festlv/uSMU/Enclosure/uSMU-top.STEP

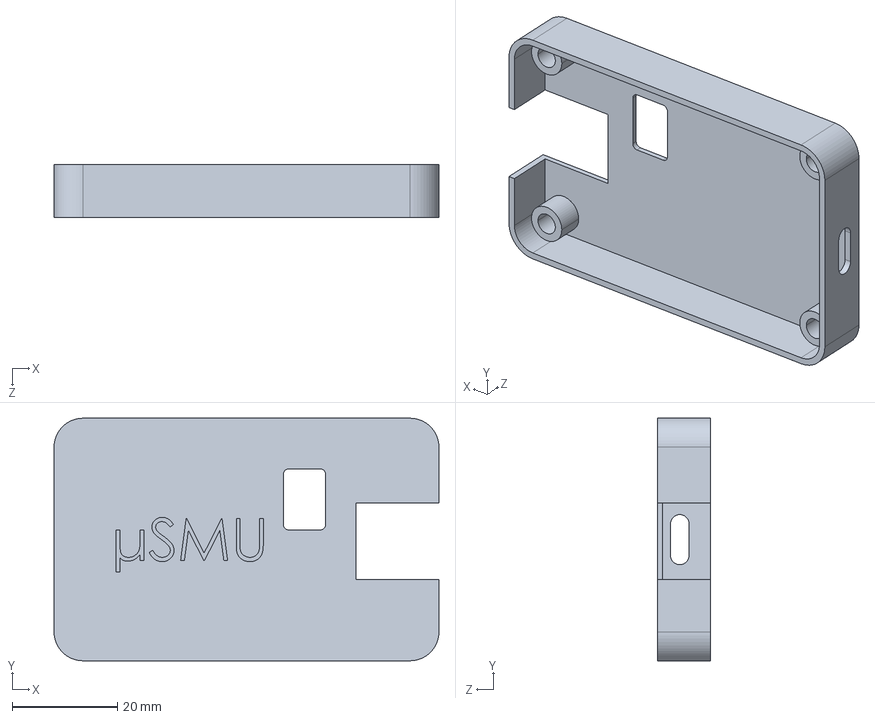
[picture p2: CAD file, 2024-10-05]
Enclosure/uSMU-top.STEP
73.0 x 46.0 x 10.1 mm
