festlv/uSMU/Enclosure/uSMU-bot.STEP

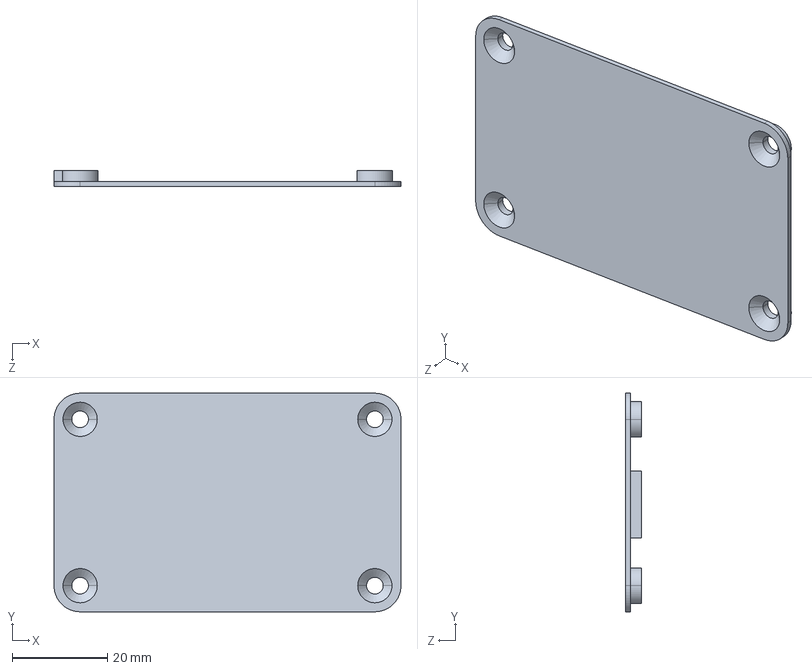
[picture p3: CAD file, 2024-10-05]
Enclosure/uSMU-bot.STEP
73.0 x 46.0 x 3.30 mm
