festlv/uSMU/(list of files, cad)

Other CAD files:
Enclosure/uSMU-bot.STL
Enclosure/uSMU-top.STL
