festlv/uSMU/Hardware/Version 10r1/uSMU_v10.kicad_pcb

## KiCad design Hardware/Version 10r1/uSMU_v10.kicad_pcb (2024-10-04)

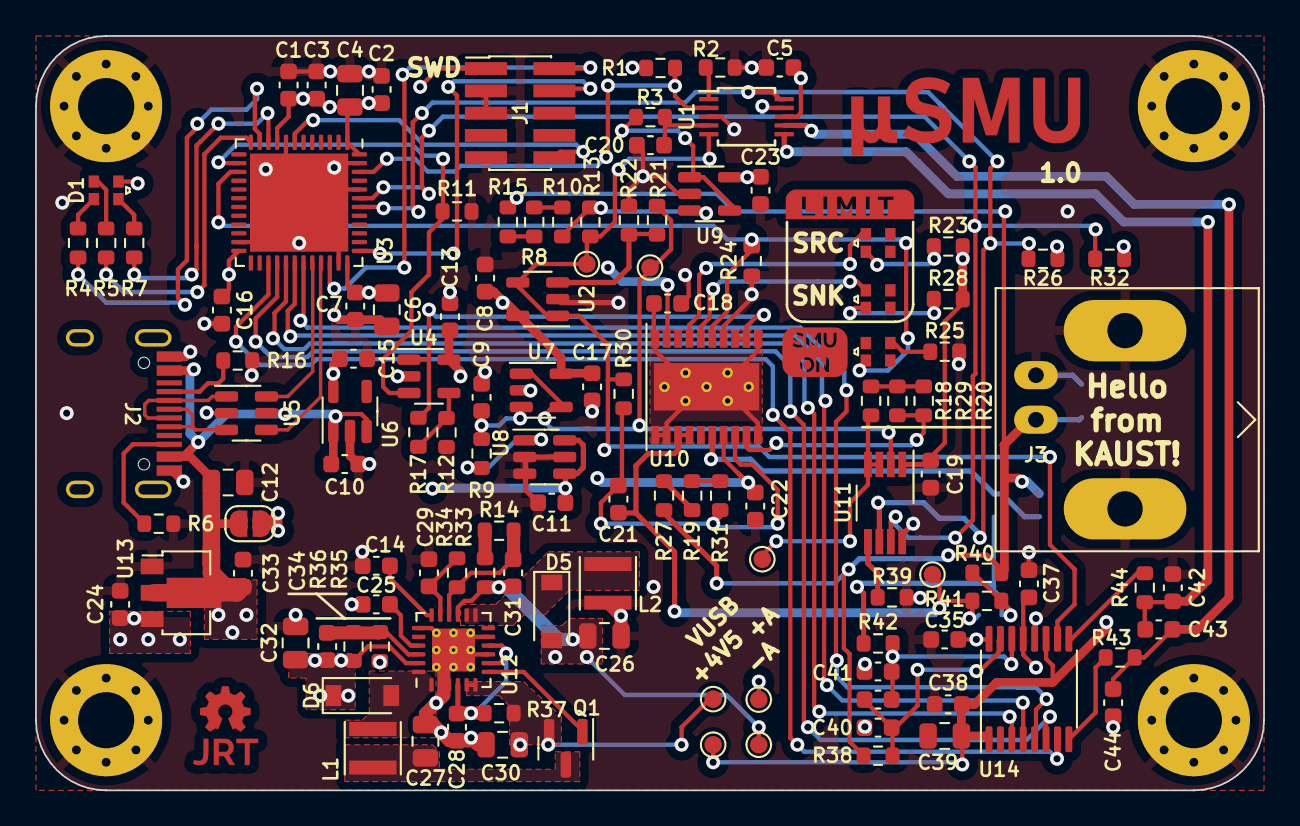
[picture p4: board uSMU_v10.kicad_pcb from above]

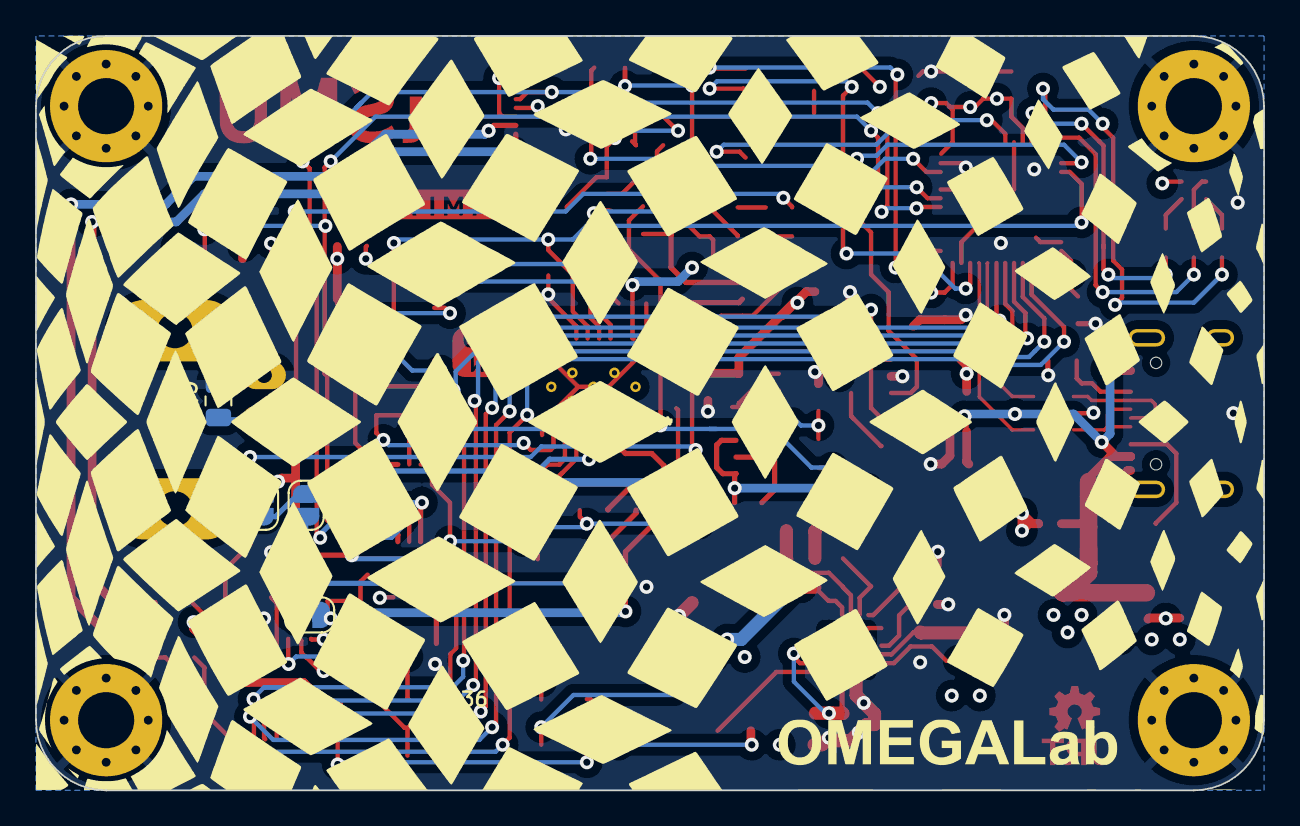
[picture p5: board uSMU_v10.kicad_pcb from below]

Board: 4 copper layers, 70.0 x 43.0 mm, 131 parts (4 on the bottom side), 77 nets.

Parts:
+1: +10V; TestPoint_Pad_D1.0mm
-1: -10V; TestPoint_Pad_D1.0mm
AmpOut1: Amp Out; TestPoint_Pad_D1.0mm
C1, C5, C8, C9, C10, C11, C13, C15, C17, C18, C19, C20, C22, C23, C24, C33, C35, C37, C38: 1uF; C_0603_1608Metric
C2, C7, C16, C28, C36: 0.1uF; C_0603_1608Metric
C3, C14, C25, C40, C41, C43: 10nF; C_0603_1608Metric
C4, C6, C12, C27, C30: 10uF; C_0805_2012Metric
C21: 200pF; C_0603_1608Metric
C26, C32: 22uF; C_0805_2012Metric
C29: 200nF; C_0603_1608Metric
C31, C34: 2pF; C_0603_1608Metric
C39, C45: DNP; C_0805_2012Metric
C42, C44: 1nF; C_0603_1608Metric
D1: Status LED; E6C0606RGBC3UDA
D2: LED; E6C0606RGBC3UDA
D3, D4: LED_Small; E6C0606RGBC3UDA
D5, D6: B5819W; D_SOD-123
H1, H2, H3, H4: MountingHole; MountingHole_3.2mm_M3_Pad_Via
J1: SWD; PinHeader_2x05_P1.27mm_Vertical_SMD
J2: USB_C_Receptacle_USB2.0; TYPE-C-31-M-12
J3: DUT; BNC_Amphenol_B6252HB-NPP3G-50_Horizontal
JP1, JP2, JP3, JP4: SolderJumper_2_Open; SolderJumper-2_P1.3mm_Open_RoundedPad1.0x1.5mm
L1, L2: 4.7uH; L_Taiyo-Yuden_MD-3030
Q1: AO3401A; SOT-23
R1, R2, R8, R9, R10, R11, R12, R13, R15, R17, R18, R19, R20, R21, R22, R24, R26, R27, R29, R30, R31, R32, R39: 10k; R_0603_1608Metric
R3, R4, R5, R7, R23, R25, R28: 1k; R_0603_1608Metric
R6, R16: 5.1k; R_0603_1608Metric
R14, R36: 330k; R_0603_1608Metric
R33, R34, R35: 47k; R_0603_1608Metric
R37, R38, R42, R43, R44: 100; R_0603_1608Metric
R40: 50; R_0603_1608Metric
R41: 10; R_0603_1608Metric
TP1: 2V048 Buf; TestPoint_Pad_D1.0mm
TP2: DAC Out; TestPoint_Pad_D1.0mm
TP3: 4V096; TestPoint_Pad_D1.0mm
TP4, TP5: TestPoint; TestPoint_Pad_D1.0mm
U1: ADS1115IDGS; TSSOP-10_3x3mm_P0.5mm
U2, U7, U9: GS8331; SOT-23-5
U3: STM32F072C8Ux; QFN-48-1EP_7x7mm_P0.5mm_EP5.6x5.6mm
U4: TS321; SOT-23-5
U5: USBLC6-2SC6; SOT-23-6
U6: ME6212C33M5G; SOT-23-5
U8: MCP1501T-40E_CHY; SOT-23-6
U10: LT1970; Linear_FE_TSSOP20
U11: DAC8571IDGKR; VSSOP-8_3.0x3.0mm_P0.65mm
U12: TPS65131RGET; VQFN-24-1EP_4x4mm_P0.5mm_EP2.45x2.45mm_ThermalVias
U13: H7650-45PR; SOT-89-3
U14: PGA281; TSSOP-16_4.4x5mm_P0.65mm

Connections:
+3V3: C1.1, C2.1, C3.1, C4.1, C6.1, C7.1, C15.1, C16.1, D1.2 (A), J1.1, U3.1 (VBAT), U3.9 (VDDA), U3.24 (VDD), U3.36 (VDDIO2), U3.48 (VDD), U6.5 (OUT)
+4V5: C5.1, C8.1, C11.2, C17.1, C19.1, C23.1, C24.1, C38.1, C39.1, JP1.2 (B), R1.2, R23.2, R26.1, R28.2, R32.1, TP5.1, U1.8 (VDD), U2.5 (V+), U7.5 (V+), U8.4 (/SHDN), U8.6 (VDD), U9.5 (V+), U11.1 (VDD), U13.3 (VOUT), U14.1 (VDD), U14.11 (VSOP)
+10V: +1.1, C13.1, C22.1, C32.1, C34.1, C37.1, D6.1 (K), R36.1, U4.5 (V+), U10.7 (VCC), U10.19 (V+), U12.23 (VPOS), U14.13 (VSP)
-10V: -1.1, C18.1, C26.1, C31.2, C35.1, D5.2 (A), R33.2, U10.1 (VEE), U10.2 (V-), U10.10 (VEE), U10.11 (VEE), U10.20 (VEE), U10.21 (VEE), U12.15 (VNEG), U14.16 (VSN)
/2.048V_REF: R13.1, R30.1, TP1.1, U1.5 (AIN1), U2.1, U2.4 (-), U14.10 (VOCM)
/+4V096: R21.1, TP3.1, U7.1, U7.4 (-), U11.2 (VREF)
/ADC_ALERT: R1.1, U1.2 (ALERT/RDY), U3.46 (PB9)
/AMP_EN: D2.2 (A), R24.2, U3.15 (PA5), U10.15 (EN)
/I_DAC: R11.2, U3.14 (PA4), U4.3 (+)
/I_G0: U3.27 (PB14), U14.7 (G0)
/I_G1: U3.28 (PB15), U14.6 (G1)
/I_G2: U3.31 (PA10), U14.5 (G2)
/I_G3: U3.30 (PA9), U14.4 (G3)
/I_G4: U3.29 (PA8), U14.3 (G4)
/I_LIM: R17.1, U4.1, U10.12 (VCsink), U10.13 (VCsrc)
/NRST: J1.10, U3.7 (NRST)
/SCL: R26.2, U1.10 (SCL), U3.42 (PB6), U11.6 (SCL)
/SDA: R32.2, U1.9 (SDA), U3.43 (PB7), U11.7 (SDA)
/SWCLK: J1.4, U3.37 (PA14)
/SWDIO: J1.2, U3.34 (PA13)
/USB_CONN_DN: J2.A7 (D-), J2.B7 (D-), U5.1 (I/O1)
/USB_CONN_DP: J2.A6 (D+), J2.B6 (D+), U5.3 (I/O2)
/USB_D+: U3.33 (PA12), U5.4 (I/O2)
/USB_D-: U3.32 (PA11), U5.6 (I/O1)
GND: C1.2, C2.2, C3.2, C4.2, C5.2, C6.2, C7.2, C8.2, C9.2, C10.2, C11.1, C12.2, C13.2, C14.2, C15.2, C16.2, C17.2, C18.2, C19.2, C20.2, C22.2, C23.2, C24.2, C25.2, C26.2, C27.2, C28.2, C29.2, C30.2, C32.2, C33.2, C35.2, C37.2, C38.2, C39.2, C40.2, C41.1, C42.1, C44.2, C45.2, H1.1, H2.1, H3.1, H4.1, J1.3, J1.5, J1.9, J2.A1 (GND), J2.A12 (GND), J3.2 (Ext), L2.2, R2.2, R6.2, R11.1, R12.2, R16.2, R22.2, R24.1, R25.2, R35.2, R39.2, U1.3 (GND), U2.2 (V-), U3.8 (VSSA), U3.23 (VSS), U3.35 (VSS), U3.44 (BOOT0), U3.47 (VSS), U3.49 (VSS), U4.2 (V-), U5.2 (GND), U6.2 (GND), U7.2 (V-), U8.2 (GND), U8.3 (GND), U8.5 (GND), U9.2 (V-), U10.14 (COM), U11.8 (GND), U12.2 (PGND_1), U12.3 (PGND_2), U12.9 (PSP), U12.11 (PSN), U12.19 (AGND), U12.25 (POWERPAD), U13.1 (GND), U14.12 (VSON)
unnamed: AmpOut1.1, C21.2, JP4.1 (A), R41.2, U10.3 (OUT), U10.4 (SENSE+)
unnamed: C9.1, R9.1, U7.3 (+)
unnamed: C14.1, U12.18 (CN)
unnamed: C20.1, R3.2, U1.4 (AIN0)
unnamed: C21.1, R30.2, R31.1, U10.8 (IN-)
unnamed: C25.1, U12.21 (CP)
unnamed: C27.1, L1.1, Q1.3 (D)
unnamed: C28.1, R37.2, U12.4 (VIN), U12.8 (ENP), U12.10 (ENN)
unnamed: C29.1, R34.1, U12.17 (VREF)
unnamed: C31.1, R14.1, R34.2, U12.16 (FBN)
unnamed: C34.2, R35.1, R36.2, U12.22 (FBP)
unnamed: C36.1, C41.2, R42.2, U14.14 (VIN+)
unnamed: C36.2, C40.1, R38.2, U14.15 (VIN-)
unnamed: C42.2, C43.1, R44.2, U1.6 (AIN2)
unnamed: C43.2, C44.1, R43.2, U1.7 (AIN3)
unnamed: C45.1, J3.1 (In), JP3.1 (A), R15.2, R27.2, R38.1, R40.1
unnamed: D1.1 (BK), R5.2
unnamed: D1.3 (GK), R4.2
unnamed: D1.4 (RK), R7.2
unnamed: D2.3 (K), R25.1
unnamed: D3.2 (A), R23.1
unnamed: D3.4 (K), U10.16 (/ISRC)
unnamed: D4.2 (A), R28.1
unnamed: D4.4 (K), U10.17 (/ISINK)
unnamed: D5.1 (K), L2.1, U12.13 (OUTN_1), U12.14 (OUTN_2)
unnamed: D6.2 (A), L1.2, U12.1 (INP_1), U12.24 (INP_2)
unnamed: J2.A5 (CC1), R16.1
unnamed: J2.B5 (CC2), R6.1
unnamed: JP2.2 (B), JP3.2 (B), U10.6 (SENSE-)
unnamed: JP2.1 (A), JP4.2 (B), R40.2, R41.1, R42.1
unnamed: Q1.1 (G), U12.7 (BSW)
unnamed: R2.1, U1.1 (ADDR)
unnamed: R3.1, U9.1, U9.4 (-)
unnamed: R4.1, U3.11 (PA1)
unnamed: R5.1, U3.12 (PA2)
unnamed: R7.1, U3.10 (PA0)
unnamed: R9.2, U8.1 (OUT)
unnamed: R10.1, R13.2, U9.3 (+)
unnamed: R8.1, R10.2
unnamed: R12.1, R17.2, U4.4 (-)
unnamed: R14.2, R33.1
unnamed: R8.2, R15.1
unnamed: R18.1, TP2.1, U11.3 (VSENSE), U11.4 (VOUT)
unnamed: R18.2, R20.1, R29.1
unnamed: R19.1, R31.2
unnamed: R19.2, R27.1
unnamed: R20.2, R29.2, U10.9 (IN+)
unnamed: R21.2, R22.1, U2.3 (+)
unnamed: R39.1, U11.5 (A0)
unnamed: R43.1, U14.8 (VON)
unnamed: R44.1, U14.9 (VOP)
VBUS: C10.1, C12.1, C30.1, C33.1, J2.A4 (VBUS), J2.A9 (VBUS), JP1.1 (A), Q1.2 (S), R37.1, TP4.1, U5.5 (VBUS), U6.1 (IN), U6.3 (EN), U12.5 (INN_1), U12.6 (INN_2), U13.2 (VIN)
