festlv/uSMU/Firmware/For HW version 10/Core/Src/main.c

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
/* Includes ------------------------------------------------------------------*/
#include "main.h"
#include "usb_device.h"

/* USER CODE BEGIN Includes */
#include "usbd_cdc_if.h"
#include "stdbool.h"
#include "stdlib.h"

#include "ee.h"
/* USER CODE END Includes */

/* USER CODE BEGIN PTD */
#define ADS1115_ADDRESS 0x48 // I2C addresses of ADC and DAC
#define DAC8571_ADDRESS 0x4C
/* USER CODE END PTD */

DAC_HandleTypeDef hdac;

I2C_HandleTypeDef hi2c1;

/* USER CODE BEGIN PV */
uint8_t UserRxBuffer[128];
bool usbMessageReceived = false;

bool calibration_mode = false;
bool auto_gain_active = true;

float shunt_resistance = 49.9; // Resistance of shunt resistor in ohms

float i_amp_gain = 1.375; // Gain setting of current-sense amplifier

uint16_t num_oversamples = 25;

float x_ilim = 0;
float y_ilim = 0;

float dac_xadj = 0;
float dac_yadj = 0;

float zerocurrent_x = 0;
float zerocurrent_y = 0;

// 1.375x gain
float zerocurrent_x_1p375 = 0;
float zerocurrent_y_1p375 = 0;

// 8x gain
float zerocurrent_x_8 = 0;
float zerocurrent_y_8 = 0;

// 64x gain
float zerocurrent_x_64 = 0;
float zerocurrent_y_64 = 0;

// 176x gain
float zerocurrent_x_176 = 0;
float zerocurrent_y_176 = 0;

float v_xadj = 0;
float v_yadj = 0;

/* USER CODE END PV */

void SystemClock_Config(void);
static void MX_GPIO_Init(void);
static void MX_DAC_Init(void);
static void MX_I2C1_Init(void);
/* USER CODE BEGIN 0 */
uint16_t adc_read_differential(uint8_t channel)
{
	uint8_t conversion_reg = 0x00;
	uint8_t config_reg = 0x01;
	uint8_t lothresh_reg = 0x02;
	uint8_t hithresh_reg = 0x03;

	unsigned char ADSwrite[6];
	int16_t reading;

	switch (channel)
	{
	case 0:
		ADSwrite[1] = 0b10000011;
		break;
	case 2:
		ADSwrite[1] = 0b10110011;
		break;
	}

	//HAL_GPIO_WritePin(GPIOA, LEDR_Pin, GPIO_PIN_SET);

	ADSwrite[0] = config_reg; // Point to config register
	ADSwrite[2] = 0b10001000; // 128SPS. For Alert pin, set COMP_QUE to anything but 11. Active low

	HAL_I2C_Master_Transmit(&hi2c1, ADS1115_ADDRESS << 1, ADSwrite, 3, 100);

	while (HAL_GPIO_ReadPin(ADC_Alert_GPIO_Port, ADC_Alert_Pin) == 0)
	{
		//HAL_GPIO_WritePin(GPIOA, LEDR_Pin, GPIO_PIN_RESET);
	}
	//HAL_GPIO_WritePin(GPIOA, LEDR_Pin, GPIO_PIN_SET);

	ADSwrite[0] = conversion_reg; // Now point to conversion register

	HAL_I2C_Master_Transmit(&hi2c1, ADS1115_ADDRESS << 1, ADSwrite, 1, 100);

	HAL_I2C_Master_Receive(&hi2c1, ADS1115_ADDRESS << 1, ADSwrite, 2, 100);
	reading = (ADSwrite[0] << 8 | ADSwrite[1]);

	return reading;
}

void adc_init()
{
	uint8_t conversion_reg = 0x00;
	uint8_t config_reg = 0x01;
	uint8_t lothresh_reg = 0x02;
	uint8_t hithresh_reg = 0x03;

	unsigned char ADSwrite[6];

	ADSwrite[0] = hithresh_reg;
	ADSwrite[1] = 0x80;
	ADSwrite[2] = 0x00;
	HAL_I2C_Master_Transmit(&hi2c1, ADS1115_ADDRESS << 1, ADSwrite, 3, 100);

	ADSwrite[0] = lothresh_reg;
	ADSwrite[1] = 0x7F;
	ADSwrite[2] = 0xFF;
	HAL_I2C_Master_Transmit(&hi2c1, ADS1115_ADDRESS << 1, ADSwrite, 3, 100);
}

uint16_t adc_read_singleended(uint8_t channel)
{
	uint8_t conversion_reg = 0x00;
	uint8_t config_reg = 0x01;

	unsigned char ADSwrite[6];
	int16_t reading;

	switch (channel)
	{
	case 0:
		ADSwrite[1] = 0xC3;
		break;
	case 1:
		ADSwrite[1] = 0xD3;
		break;
	case 2:
		ADSwrite[1] = 0xE3;
		break;
	case 3:
		ADSwrite[1] = 0xF3;
		break;
	}

	ADSwrite[0] = config_reg; // Point to config register
	ADSwrite[2] = 0b10001000; // 128SPS. For Alert pin, set COMP_QUE to anything but 11. Active low

	HAL_I2C_Master_Transmit(&hi2c1, ADS1115_ADDRESS << 1, ADSwrite, 3, 100);

	while (HAL_GPIO_ReadPin(ADC_Alert_GPIO_Port, ADC_Alert_Pin) == 0)
	{
		//HAL_GPIO_WritePin(GPIOA, LEDR_Pin, GPIO_PIN_RESET);
	}
	//HAL_GPIO_WritePin(GPIOA, LEDR_Pin, GPIO_PIN_SET);

	ADSwrite[0] = conversion_reg; // Now point to conversion register

	HAL_I2C_Master_Transmit(&hi2c1, ADS1115_ADDRESS << 1, ADSwrite, 1, 100);

	HAL_I2C_Master_Receive(&hi2c1, ADS1115_ADDRESS << 1, ADSwrite, 2, 100);
	reading = (ADSwrite[0] << 8 | ADSwrite[1]);
	if (reading < 0)
	{
		reading = 0;
	}
	return reading;
}

void set_current_limit(float current_ma)
{
	if (current_ma > 40)
	{
		float current_ma = 40;
	}
	float dac_level = (current_ma * x_ilim) + y_ilim;

	uint16_t dac_level_int = (int) dac_level;

	HAL_DAC_SetValue(&hdac, DAC_CHANNEL_1, DAC_ALIGN_12B_R, dac_level_int);
	HAL_DAC_Start(&hdac, DAC_CHANNEL_1);
}

void DAC8571_amp_dac_write(uint16_t level)
{
	unsigned char DACbuffer[3];

	DACbuffer[0] = 0b00010000; //Set write mode
	DACbuffer[1] = level >> 8;
	DACbuffer[2] = level;

	HAL_I2C_Master_Transmit(&hi2c1, DAC8571_ADDRESS << 1, DACbuffer, 3, 100);
}

void dac_write_voltage(float voltage)
{
	float flevel = (dac_xadj * voltage) + dac_yadj;
	uint16_t level = round(flevel);
	DAC8571_amp_dac_write(level);
}

void adc(uint8_t channel)
{
	uint16_t adc = adc_read_differential(channel);
	char adcmsg[16];
	memset(adcmsg, 0, sizeof(adcmsg));
	sprintf(adcmsg, "%d", adc);
	CDC_Transmit_FS(adcmsg, strlen(adcmsg));
}

void single_shot()
{
	float voltage_running = 0;
	float current_running = 0;

	for (int i = 0; i < num_oversamples; i++)
	{
		uint16_t v_measure = adc_read_singleended(0);

		int16_t i_measure = adc_read_differential(2);
		float voltage = 0;
		if (calibration_mode == false)
		{
			voltage = (v_measure * v_xadj) + v_yadj;
		}
		else
		{
			voltage = v_measure;
		}

		float current = (i_measure * 0.125 / 1000) / shunt_resistance
				/ i_amp_gain;
		current = current + ((zerocurrent_x * voltage) + zerocurrent_y);
		float current_abs = fabs(current);

		// Set programmable gain amplifier based on the last measured current
		if (auto_gain_active == true)
		{
			if (current_abs > 1E-2)
			{
				// Purple
				set_pga_gain_1p375();
			}
			if (current_abs > 1E-3 && current_abs <= 1E-2)
			{
				// Red
				set_pga_gain_8();
			}
			if (current_abs > 1E-4 && current_abs <= 1E-3)
			{
				// Green
				set_pga_gain_64();
			}
			if (current_abs < 1E-5)
			{
				// Blue
				set_pga_gain_176();
			}
		}

		voltage_running += voltage;
		current_running += current;
	}

	voltage_running /= num_oversamples;
	current_running /= num_oversamples;

	char vmsg[32];
	char imsg[32];

	memset(vmsg, 0, sizeof(vmsg));
	memset(imsg, 0, sizeof(imsg));

	sprintf(vmsg, "%4.3f", voltage_running);
	sprintf(imsg, "%e", current_running);

	strcat(vmsg, ",");
	strcat(vmsg, imsg);

	strcat(vmsg, "\n");
	CDC_Transmit_FS(vmsg, strlen(vmsg));

}

void set_pga_gain_1p375()
{
	HAL_GPIO_WritePin(GPIOA, LEDR_Pin, GPIO_PIN_RESET);
	HAL_GPIO_WritePin(GPIOA, LEDG_Pin, GPIO_PIN_SET);
	HAL_GPIO_WritePin(GPIOA, LEDB_Pin, GPIO_PIN_RESET);

	HAL_GPIO_WritePin(GPIOB, I_G0_Pin, GPIO_PIN_SET);
	HAL_GPIO_WritePin(GPIOB, I_G1_Pin, GPIO_PIN_SET);
	HAL_GPIO_WritePin(GPIOA, I_G2_Pin, GPIO_PIN_RESET);
	HAL_GPIO_WritePin(GPIOA, I_G3_Pin, GPIO_PIN_RESET);
	HAL_GPIO_WritePin(GPIOA, I_G4_Pin, GPIO_PIN_SET);
	// 01001

	i_amp_gain = 1.375;
	if (calibration_mode == false)
	{
		zerocurrent_x = zerocurrent_x_1p375;
		zerocurrent_y = zerocurrent_y_1p375;
	}
}

void set_pga_gain_8()
{
	HAL_GPIO_WritePin(GPIOA, LEDR_Pin, GPIO_PIN_RESET);
	HAL_GPIO_WritePin(GPIOA, LEDG_Pin, GPIO_PIN_SET);
	HAL_GPIO_WritePin(GPIOA, LEDB_Pin, GPIO_PIN_SET);

	HAL_GPIO_WritePin(GPIOB, I_G0_Pin, GPIO_PIN_RESET);
	HAL_GPIO_WritePin(GPIOB, I_G1_Pin, GPIO_PIN_SET);
	HAL_GPIO_WritePin(GPIOA, I_G2_Pin, GPIO_PIN_SET);
	HAL_GPIO_WritePin(GPIOA, I_G3_Pin, GPIO_PIN_RESET);
	HAL_GPIO_WritePin(GPIOA, I_G4_Pin, GPIO_PIN_RESET);

	i_amp_gain = 8;
	if (calibration_mode == false)
	{
		zerocurrent_x = zerocurrent_x_8;
		zerocurrent_y = zerocurrent_y_8;
	}

}

void set_pga_gain_64()
{
	HAL_GPIO_WritePin(GPIOA, LEDR_Pin, GPIO_PIN_SET);
	HAL_GPIO_WritePin(GPIOA, LEDG_Pin, GPIO_PIN_RESET);
	HAL_GPIO_WritePin(GPIOA, LEDB_Pin, GPIO_PIN_SET);

	HAL_GPIO_WritePin(GPIOB, I_G0_Pin, GPIO_PIN_SET);
	HAL_GPIO_WritePin(GPIOB, I_G1_Pin, GPIO_PIN_RESET);
	HAL_GPIO_WritePin(GPIOA, I_G2_Pin, GPIO_PIN_RESET);
	HAL_GPIO_WritePin(GPIOA, I_G3_Pin, GPIO_PIN_SET);
	HAL_GPIO_WritePin(GPIOA, I_G4_Pin, GPIO_PIN_RESET);

	i_amp_gain = 64;
	if (calibration_mode == false)
	{
		zerocurrent_x = zerocurrent_x_64;
		zerocurrent_y = zerocurrent_y_64;
	}
}

void set_pga_gain_176()
{
	HAL_GPIO_WritePin(GPIOA, LEDR_Pin, GPIO_PIN_SET);
	HAL_GPIO_WritePin(GPIOA, LEDG_Pin, GPIO_PIN_SET);
	HAL_GPIO_WritePin(GPIOA, LEDB_Pin, GPIO_PIN_RESET);

	HAL_GPIO_WritePin(GPIOB, I_G0_Pin, GPIO_PIN_RESET);
	HAL_GPIO_WritePin(GPIOB, I_G1_Pin, GPIO_PIN_SET);
	HAL_GPIO_WritePin(GPIOA, I_G2_Pin, GPIO_PIN_RESET);
	HAL_GPIO_WritePin(GPIOA, I_G3_Pin, GPIO_PIN_SET);
	HAL_GPIO_WritePin(GPIOA, I_G4_Pin, GPIO_PIN_SET);

	i_amp_gain = 176;
	if (calibration_mode == false)
	{
		zerocurrent_x = zerocurrent_x_176;
		zerocurrent_y = zerocurrent_y_176;
	}
}

void read_eeprom()
{
	// Reads calibration data from emulated EEPROM

	uint8_t dataBuffer[4];

	memset(dataBuffer, 0, sizeof(dataBuffer));
	ee_read(0, 4, dataBuffer);
	memcpy(&dac_xadj, dataBuffer, sizeof dac_xadj);

	memset(dataBuffer, 0, sizeof(dataBuffer));
	ee_read(4, 4, dataBuffer);
	memcpy(&dac_yadj, dataBuffer, sizeof dac_yadj);

	memset(dataBuffer, 0, sizeof(dataBuffer));
	ee_read(8, 4, dataBuffer);
	memcpy(&v_xadj, dataBuffer, sizeof v_xadj);

	memset(dataBuffer, 0, sizeof(dataBuffer));
	ee_read(12, 4, dataBuffer);
	memcpy(&v_yadj, dataBuffer, sizeof v_yadj);

	memset(dataBuffer, 0, sizeof(dataBuffer));
	ee_read(16, 4, dataBuffer);
	memcpy(&zerocurrent_x_8, dataBuffer, sizeof zerocurrent_x_8);

	memset(dataBuffer, 0, sizeof(dataBuffer));
	ee_read(20, 4, dataBuffer);
	memcpy(&zerocurrent_y_8, dataBuffer, sizeof zerocurrent_y_8);

	memset(dataBuffer, 0, sizeof(dataBuffer));
	ee_read(24, 4, dataBuffer);
	memcpy(&zerocurrent_x_64, dataBuffer, sizeof zerocurrent_x_64);

	memset(dataBuffer, 0, sizeof(dataBuffer));
	ee_read(28, 4, dataBuffer);
	memcpy(&zerocurrent_y_64, dataBuffer, sizeof zerocurrent_y_64);

	memset(dataBuffer, 0, sizeof(dataBuffer));
	ee_read(32, 4, dataBuffer);
	memcpy(&zerocurrent_x_176, dataBuffer, sizeof zerocurrent_x_176);

	memset(dataBuffer, 0, sizeof(dataBuffer));
	ee_read(36, 4, dataBuffer);
	memcpy(&zerocurrent_y_176, dataBuffer, sizeof zerocurrent_y_176);

	memset(dataBuffer, 0, sizeof(dataBuffer));
	ee_read(40, 4, dataBuffer);
	memcpy(&x_ilim, dataBuffer, sizeof x_ilim);

	memset(dataBuffer, 0, sizeof(dataBuffer));
	ee_read(44, 4, dataBuffer);
	memcpy(&y_ilim, dataBuffer, sizeof y_ilim);

	memset(dataBuffer, 0, sizeof(dataBuffer));
	ee_read(48, 4, dataBuffer);
	memcpy(&zerocurrent_x_1p375, dataBuffer, sizeof zerocurrent_x_1p375);

	memset(dataBuffer, 0, sizeof(dataBuffer));
	ee_read(52, 4, dataBuffer);
	memcpy(&zerocurrent_y_1p375, dataBuffer, sizeof zerocurrent_y_1p375);
}

void dacReadBack()
{
	unsigned char DACbuffer[3];

	DACbuffer[0] = 00000000; //Set write mode
	DACbuffer[1] = 00000000;
	DACbuffer[2] = 00000000;

	HAL_I2C_Master_Receive(&hi2c1, DAC8571_ADDRESS << 1, DACbuffer, 3, 100);

	uint16_t reading = (DACbuffer[0] << 8 | DACbuffer[1]);

}

/* USER CODE END 0 */

/**
 * @brief  The application entry point.
 * @retval int
 */
int main(void)
{
	/* MCU Configuration--------------------------------------------------------*/

	/* Reset of all peripherals, Initializes the Flash interface and the Systick. */
	HAL_Init();

	/* Configure the system clock */
	SystemClock_Config();

	/* Initialize all configured peripherals */
	MX_GPIO_Init();
	MX_DAC_Init();
	MX_I2C1_Init();
	MX_USB_DEVICE_Init();
	/* USER CODE BEGIN 2 */

	adc_init();
	ee_init();
	read_eeprom();

	// RESET = LOW, SET = HIGH
	HAL_GPIO_WritePin(GPIOA, LEDR_Pin, GPIO_PIN_RESET);
	HAL_GPIO_WritePin(GPIOA, LEDG_Pin, GPIO_PIN_RESET);
	HAL_GPIO_WritePin(GPIOA, LEDB_Pin, GPIO_PIN_RESET);

	HAL_GPIO_WritePin(GPIOB, I_G0_Pin, GPIO_PIN_RESET);
	HAL_GPIO_WritePin(GPIOB, I_G1_Pin, GPIO_PIN_RESET);
	HAL_GPIO_WritePin(GPIOA, I_G2_Pin, GPIO_PIN_RESET);
	HAL_GPIO_WritePin(GPIOA, I_G3_Pin, GPIO_PIN_RESET);
	HAL_GPIO_WritePin(GPIOA, I_G4_Pin, GPIO_PIN_RESET);

	//set_pga_gain_8();
	set_pga_gain_1p375();
	/* USER CODE END 2 */

	/* Infinite loop */
	/* USER CODE BEGIN WHILE */
	while (1)
	{
		if (usbMessageReceived == true)
		{
			//RGB_Led_SetIntensity(2, 0, 0, 100);

			char chRxBuffer[2048];

			// Take the uint8_t buffer and turn it into a char array
			for (int i = 0; i <= 2048; i++)
			{
				chRxBuffer[i] = UserRxBuffer[i];
			}

			usbMessageReceived = false;

			char manualDACSearch[] = "DAC";
			char manualCurDACSearch[] = "ILIM";

			char adcSearch[] = "ADC";

			char ampEnableSearch[] = "CH1:ENA";
			char ampDisableSearch[] = "CH1:DIS";
			char setVoltageSearch[] = "CH1:VOL";
			char setMeasVoltageSearch[] = "CH1:MEA:VOL";

			char setCurrLimitSearch[] = "CH1:CUR";
			char setOversamplesSearch[] = "CH1:OSR";
			char setVCalModeSearch[] = "CH1:VCAL";
			char setManualRangeSearch[] = "CH1:RANGE";
			char setResetSearch[] = "*RST";
			char idnSearch[] = "*IDN?";

			char writeSearch[] = "WRITE";
			char readSearch[] = "*READ";

			char dacCalSearch[] = "CAL:DAC";
			char vCalSearch[] = "CAL:VOL";
			char iCal1p375Search[] = "CAL:CUR:RANGE1";
			char iCal8Search[] = "CAL:CUR:RANGE2";
			char iCal64Search[] = "CAL:CUR:RANGE3";
			char iCal176Search[] = "CAL:CUR:RANGE4";
			char iLimCalSearch[] = "CAL:ILIM";

			char *manualDACPtr = strstr(chRxBuffer, manualDACSearch);
			char *manualCurDACPtr = strstr(chRxBuffer, manualCurDACSearch);

			char *manualADCPtr = strstr(chRxBuffer, adcSearch);

			char *writeEEPtr = strstr(chRxBuffer, writeSearch);
			char *readEEPtr = strstr(chRxBuffer, readSearch);

			char *dacCalPtr = strstr(chRxBuffer, dacCalSearch);
			char *vCalPtr = strstr(chRxBuffer, vCalSearch);
			char *iCal1p375Ptr = strstr(chRxBuffer, iCal1p375Search);
			char *iCal8Ptr = strstr(chRxBuffer, iCal8Search);
			char *iCal64Ptr = strstr(chRxBuffer, iCal64Search);
			char *iCal176Ptr = strstr(chRxBuffer, iCal176Search);
			char *iLimCalPtr = strstr(chRxBuffer, iLimCalSearch);

			char *ampEnablePtr = strstr(chRxBuffer, ampEnableSearch);
			char *ampDisablePtr = strstr(chRxBuffer, ampDisableSearch);
			char *setVoltagePtr = strstr(chRxBuffer, setVoltageSearch);
			char *setMeasVoltagePtr = strstr(chRxBuffer, setMeasVoltageSearch);

			char *setCurrLimitPtr = strstr(chRxBuffer, setCurrLimitSearch);
			char *setOSRPtr = strstr(chRxBuffer, setOversamplesSearch);
			char *setVCalModePtr = strstr(chRxBuffer, setVCalModeSearch);
			char *setManualRangePtr = strstr(chRxBuffer, setManualRangeSearch);
			char *resetPtr = strstr(chRxBuffer, setResetSearch);
			char *idnPtr = strstr(chRxBuffer, idnSearch);

			if (ampEnablePtr != NULL)
			{
				HAL_GPIO_WritePin(GPIOA, AMP_EN_Pin, 1);
			}

			else if (manualADCPtr != NULL)
			{
				strtok(chRxBuffer, " ");
				int requested_adc_channel = atoi(strtok(NULL, " "));
				adc(requested_adc_channel);
			}

			else if (ampDisablePtr != NULL)
			{
				HAL_GPIO_WritePin(GPIOA, AMP_EN_Pin, 0);
			}
			else if (setVoltagePtr != NULL)
			{
				strtok(chRxBuffer, " ");
				float requested_voltage = atof(strtok(NULL, " "));
				dac_write_voltage(requested_voltage);
			}
			else if (setMeasVoltagePtr != NULL)
			{
				strtok(chRxBuffer, " ");
				char* endptr;
				char* startptr = strtok(NULL, " ");
				if (startptr != NULL) {
					float requested_voltage = strtod(startptr, endptr);
					if (endptr != startptr)
						dac_write_voltage(requested_voltage);
				}
				HAL_Delay(1);
				single_shot();
			}

			else if (setCurrLimitPtr != NULL)
			{
				strtok(chRxBuffer, " ");
				float requested_current_limit = atof(strtok(NULL, " "));
				set_current_limit(requested_current_limit);
			}

			else if (setOSRPtr != NULL)
			{
				strtok(chRxBuffer, " ");
				num_oversamples = atoi(strtok(NULL, " "));
			}

			else if (setVCalModePtr != NULL)
			{
				calibration_mode = true;
			}
			else if (setManualRangePtr != NULL)
			{
				auto_gain_active = false;
				strtok(chRxBuffer, " ");
				uint8_t range = atoi(strtok(NULL, " "));
				switch (range)
				{
				case 0:
					set_pga_gain_1p375();
					auto_gain_active = true;
					break;
				case 1:
					set_pga_gain_1p375();
					zerocurrent_x = 0;
					zerocurrent_y = 0;
					break;
				case 2:
					set_pga_gain_8();
					zerocurrent_x = 0;
					zerocurrent_y = 0;
					break;
				case 3:
					set_pga_gain_64();
					zerocurrent_x = 0;
					zerocurrent_y = 0;
					break;
				case 4:
					set_pga_gain_176();
					zerocurrent_x = 0;
					zerocurrent_y = 0;
					break;
				}

			}
			else if (resetPtr != NULL)
			{
				NVIC_SystemReset();
			}
			else if (idnPtr != NULL)
			{
				uint32_t revision =
						READ_REG(
								*((uint32_t *)UID_BASE)) + READ_REG(*((uint32_t *)(UID_BASE + 4U))) + READ_REG(*((uint32_t *)(UID_BASE + 8U)));
				char msg[64];
				memset(msg, 0, sizeof(msg));
				sprintf(msg, "uSMU version 1.0 ID:%d", revision);
				strcat(msg, "\n");
				CDC_Transmit_FS(msg, strlen(msg));

			}

			else if (writeEEPtr != NULL)
			{
				strtok(chRxBuffer, " ");
				float num_to_write = atof(strtok(NULL, " "));

				char data[sizeof(float)];
				memcpy(data, &num_to_write, sizeof num_to_write); // send data

				ee_writeToRam(0, 4, data);
				ee_commit();
			}
			else if (dacCalPtr != NULL)
			{
				strtok(chRxBuffer, " ");
				float slope_to_write = atof(strtok(NULL, " "));
				float intercept_to_write = atof(strtok(NULL, " "));

				char x_data[sizeof(float)];
				char y_data[sizeof(float)];

				memcpy(x_data, &slope_to_write, sizeof slope_to_write); // send data
				memcpy(y_data, &intercept_to_write, sizeof intercept_to_write); // send data

				ee_writeToRam(0, 4, x_data);
				ee_writeToRam(4, 4, y_data);
				ee_commit();
			}

			else if (vCalPtr != NULL)
			{
				strtok(chRxBuffer, " ");
				float slope_to_write = atof(strtok(NULL, " "));
				float intercept_to_write = atof(strtok(NULL, " "));

				char x_data[sizeof(float)];
				char y_data[sizeof(float)];

				memcpy(x_data, &slope_to_write, sizeof slope_to_write); // send data
				memcpy(y_data, &intercept_to_write, sizeof intercept_to_write); // send data

				ee_writeToRam(8, 4, x_data);
				ee_writeToRam(12, 4, y_data);

				ee_commit();
			}
			else if (iCal1p375Ptr != NULL)
			{
				strtok(chRxBuffer, " ");
				float slope_to_write = atof(strtok(NULL, " "));
				float intercept_to_write = atof(strtok(NULL, " "));

				char x_data[sizeof(float)];
				char y_data[sizeof(float)];

				memcpy(x_data, &slope_to_write, sizeof slope_to_write); // send data
				memcpy(y_data, &intercept_to_write, sizeof intercept_to_write); // send data

				ee_writeToRam(48, 4, x_data);
				ee_writeToRam(52, 4, y_data);
				ee_commit();
			}
			else if (iCal8Ptr != NULL)
			{
				strtok(chRxBuffer, " ");
				float slope_to_write = atof(strtok(NULL, " "));
				float intercept_to_write = atof(strtok(NULL, " "));

				char x_data[sizeof(float)];
				char y_data[sizeof(float)];

				memcpy(x_data, &slope_to_write, sizeof slope_to_write); // send data
				memcpy(y_data, &intercept_to_write, sizeof intercept_to_write); // send data

				ee_writeToRam(16, 4, x_data);
				ee_writeToRam(20, 4, y_data);
				ee_commit();
			}
			else if (iCal64Ptr != NULL)
			{
				strtok(chRxBuffer, " ");
				float slope_to_write = atof(strtok(NULL, " "));
				float intercept_to_write = atof(strtok(NULL, " "));

				char x_data[sizeof(float)];
				char y_data[sizeof(float)];

				memcpy(x_data, &slope_to_write, sizeof slope_to_write); // send data
				memcpy(y_data, &intercept_to_write, sizeof intercept_to_write); // send data

				ee_writeToRam(24, 4, x_data);
				ee_writeToRam(28, 4, y_data);
				ee_commit();
			}
			else if (iCal176Ptr != NULL)
			{
				strtok(chRxBuffer, " ");
				float slope_to_write = atof(strtok(NULL, " "));
				float intercept_to_write = atof(strtok(NULL, " "));

				char x_data[sizeof(float)];
				char y_data[sizeof(float)];

				memcpy(x_data, &slope_to_write, sizeof slope_to_write); // send data
				memcpy(y_data, &intercept_to_write, sizeof intercept_to_write); // send data

				ee_writeToRam(32, 4, x_data);
				ee_writeToRam(36, 4, y_data);
				ee_commit();
			}
			else if (iLimCalPtr != NULL)
			{
				strtok(chRxBuffer, " ");
				float slope_to_write = atof(strtok(NULL, " "));
				float intercept_to_write = atof(strtok(NULL, " "));

				char x_data[sizeof(float)];
				char y_data[sizeof(float)];

				memcpy(x_data, &slope_to_write, sizeof slope_to_write); // send data
				memcpy(y_data, &intercept_to_write, sizeof intercept_to_write); // send data

				ee_writeToRam(40, 4, x_data);
				ee_writeToRam(44, 4, y_data);
				ee_commit();
			}

			else if (readEEPtr != NULL)
			{
				strtok(chRxBuffer, " ");
				int requested_address = atoi(strtok(NULL, " "));

				static uint8_t dataRead[4];
				ee_read(requested_address, 4, dataRead);
				float g;
				memcpy(&g, dataRead, sizeof g);    // receive data

				char msg[1024];
				memset(msg, 0, sizeof(msg));
				sprintf(msg, "%e", g);
				strcat(msg, "\n");
				CDC_Transmit_FS(msg, strlen(msg));

			}
			else if (manualCurDACPtr != NULL)
			{
				strtok(chRxBuffer, " ");
				int requested_level = atoi(strtok(NULL, " "));
				HAL_DAC_SetValue(&hdac, DAC_CHANNEL_1, DAC_ALIGN_12B_R,
						requested_level);
				HAL_DAC_Start(&hdac, DAC_CHANNEL_1);
			}
			else if (manualDACPtr != NULL)
			{
				strtok(chRxBuffer, " ");
				int requested_level = atoi(strtok(NULL, " "));
				DAC8571_amp_dac_write(requested_level);
			}

			else
			{
				char msg[1024] = "Test string not found";
				strcat(msg, "\n");
				CDC_Transmit_FS(msg, strlen(msg));
			}
		}
		/* USER CODE END WHILE */

		/* USER CODE BEGIN 3 */
	}
	/* USER CODE END 3 */
}

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
