festlv/uSMU/(commit log)

2024-10-04 Firmware improvements:
    * Don't send trailing 0x00s in responses
    * CH1:MEA:VOL without arguments doesn't touch voltage setpoint
    * Fix DAC I2C address
    [main.c]
2024-10-04 Hardware: back-annotate schematics from PCB
    [uSMU_v10.kicad_pcb, uSMU_v10.kicad_sch]
2024-10-05 Add 3D printed enclosure
    [uSMU-bot.STEP, uSMU-bot.STL, uSMU-top.STEP, uSMU-top.STL]
